Nikhildath/BSB--the-buzz-strikes-back-Revenge-Edition/(commit log)

2026-09-05 Fix compilation: convert .ino to .cpp, fix ESP-NOW callbacks, fix drawArc, fix INDEX_HTML ordering
    [ui_gateway.cpp]
2026-09-05 Fix .ino build: move HTML to index_html.h, fix ESP-NOW callbacks, add missing forward decls
    [ui_gateway.ino]
2026-09-05 Fix Arduino IDE build: fix ESP-NOW callbacks for core 3.x, copy headers to ui_gateway folder
    [mosquito_protocol.h, ui_gateway.ino]
2026-09-05 Add ESP32-Eyes emotic display, I2S audio, remap pins
    - Replace Adafruit_GFX/SSD1306 with U8g2 + ESP32-Eyes Face class
    for animated emoticon eyes on OLED (18 emotions, auto-blink)
    - OLED shows ONLY eyes — no text overlays
    - Scared face triggers on lift alert from trap controller
    - Switch speaker from PWM to I2S driver for MAX98357A amplifier
    - Remap I2S pins to GPIO 5 (BCLK), 18 (LRC), 19 (DIN)
    to avoid HC-SR04 and Status LED conflicts
    - WiFi event handler auto-manages web server on connect
    - Update all docs (WIRING, HARDWARE, TESTING, ARCHITECTURE)
2026-09-05 Fix I2S audio: continuous sine wave generator, phase accumulator
    - Replace broken I2S output with continuous sine wave using persistent
    phase accumulator (no more phase reset per buffer)
    - Fix volume type bug: speakerVolume uint8_t was overflowing with
    MOSQUITO_VOLUME=8000, now uses 8000.0f float amplitude
    - Increase DMA buffers from 4 to 8 for smoother playback
    - Add error logging on I2S driver/pin init failures
    - Remove silent mode I2S write from loop (controlSpeaker handles it)
    - Add temporary speaker test in setup() for hardware verification
    [trap_controller.ino]
2026-09-05 Fix MAX98357A: add amp enable pin, improve I2S config
    - Add GPIO 22 as AMP_ENABLE (SD/EN pin must be HIGH to enable amp)
    - Change I2S comm format from STAND_I2S to STAND_MSB for MAX98357A
    - Increase DMA buffer from 256 to 512 samples
    - Add testSpeaker() function with 1kHz tone for hardware verification
    - Add error checking on i2s_write()
    - Update all docs (WIRING.md, HARDWARE.md, TESTING.md) with GPIO 22
    [trap_controller.ino]
2026-09-05 Fix HC-SR04: increase read rate to 1Hz, add diagnostic output
    - Change HC-SR04 read interval from 5s to 1s for faster lift detection
    - Add serial output showing distance, baseline, and lift state
    - Helps diagnose ultrasonic sensor issues
    [trap_controller.ino]
2026-09-06 Add GitHub Pages landing site
