Nikhildath/BSB--the-buzz-strikes-back-Revenge-Edition/(notices)

Notices in the files:
firmware/esp32_ui_gateway/src/ui_gateway/Face.cpp:
This program is free software: you can redistribute it and/or modify it under the terms of the GNU Affero General Public License as published by
the Free Software Foundation, either version 3 of the License, or (at your option) any later version.
